LTGBLSN/Studying-Wheel-Legged-Robots-Damiao-/wheel-legged-master/打印件版/硬件接线图/实物图.jpg

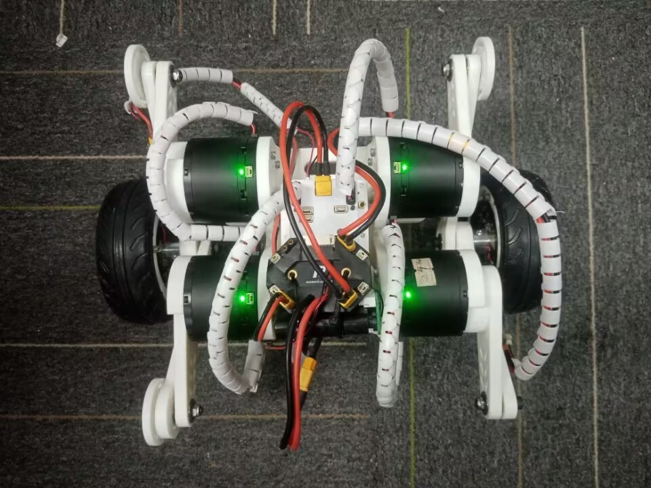
wheel-legged-master/打印件版/硬件接线图/实物图.jpg
