LTGBLSN/Studying-Wheel-Legged-Robots-Damiao-/wheel-legged-master/打印件版/代码/DM-balance打印件版本/电机零点图.jpg

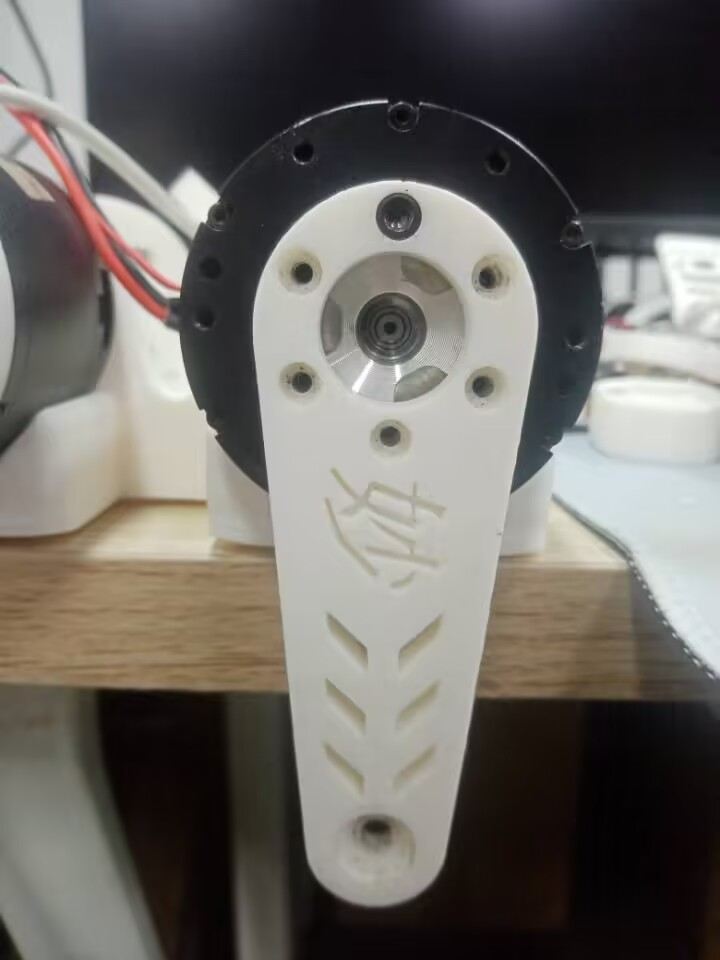
wheel-legged-master/打印件版/代码/DM-balance打印件版本/电机零点图.jpg
