LTGBLSN/Studying-Wheel-Legged-Robots-Damiao-/wheel-legged-master/打印件版/硬件接线图/轮足硬件接线图.png

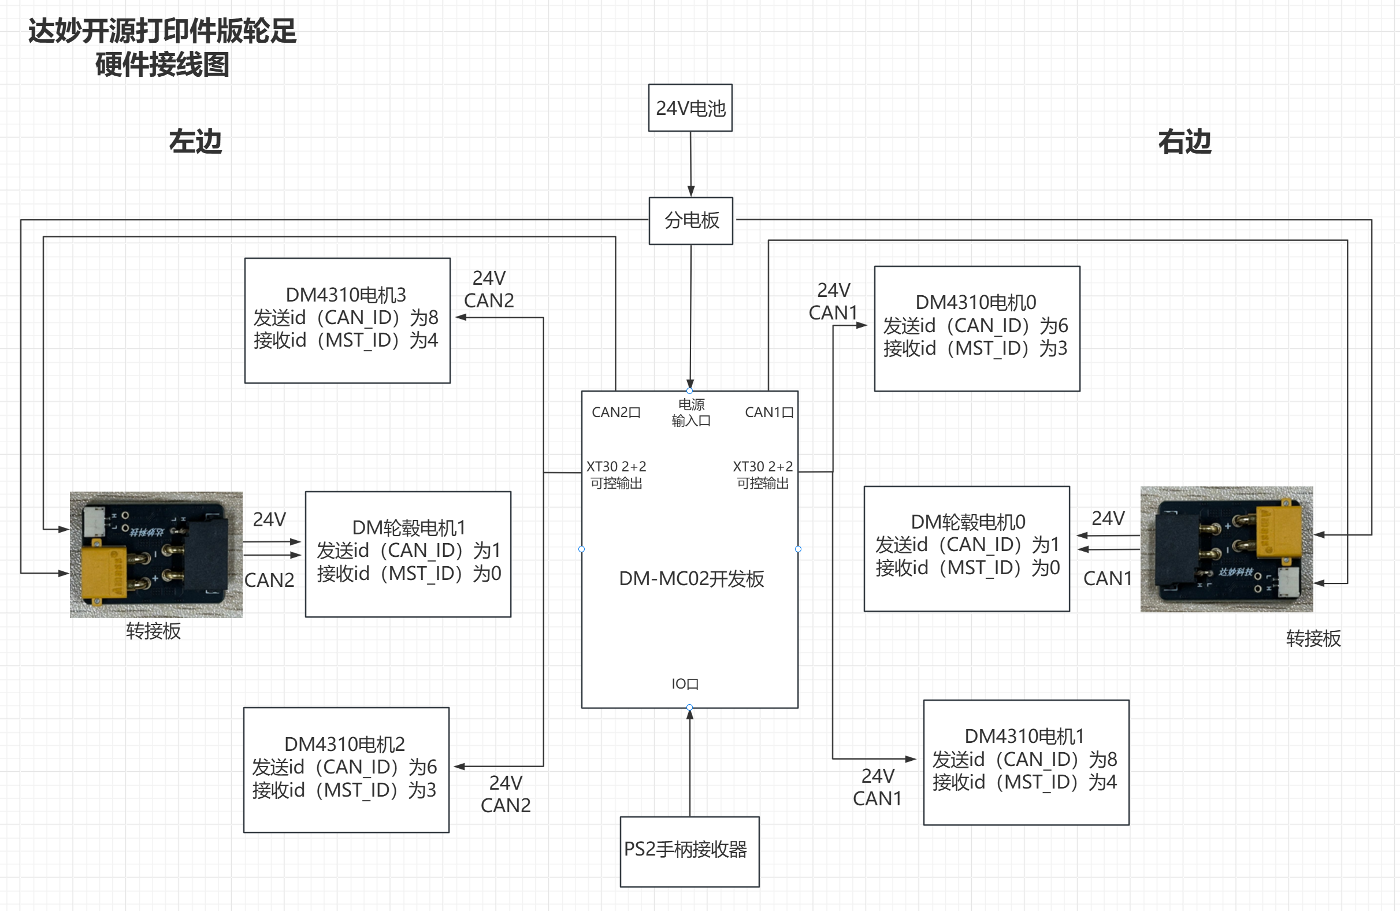
wheel-legged-master/打印件版/硬件接线图/轮足硬件接线图.png
