LTGBLSN/Studying-Wheel-Legged-Robots-Damiao-/轮腿开源（相关物料）/主控板-上壳 - 原装上壳太薄了打印出来变形,并增加了引脚的开窗.SLDPRT

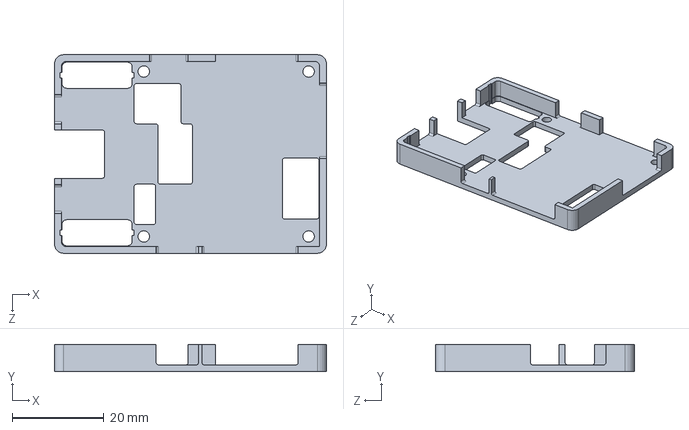
[picture p40: CAD file, 2025-12-11]
轮腿开源（相关物料）/主控板-上壳 - 原装上壳太薄了打印出来变形,并增加了引脚的开窗.SLDPRT
59.4 x 6.00 x 43.4 mm
