LTGBLSN/Studying-Wheel-Legged-Robots-Damiao-/轮腿开源（相关物料）/轮毂打印件-内圈.STL

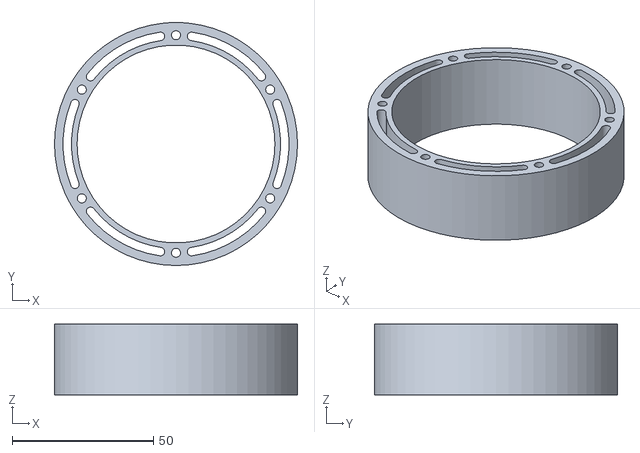
[picture p41: CAD file, 2025-12-11]
轮腿开源（相关物料）/轮毂打印件-内圈.STL
86.0 x 86.0 x 25.0
