LTGBLSN/Studying-Wheel-Legged-Robots-Damiao-/轮腿开源（相关物料）/轮毂打印件-下盖片.STL

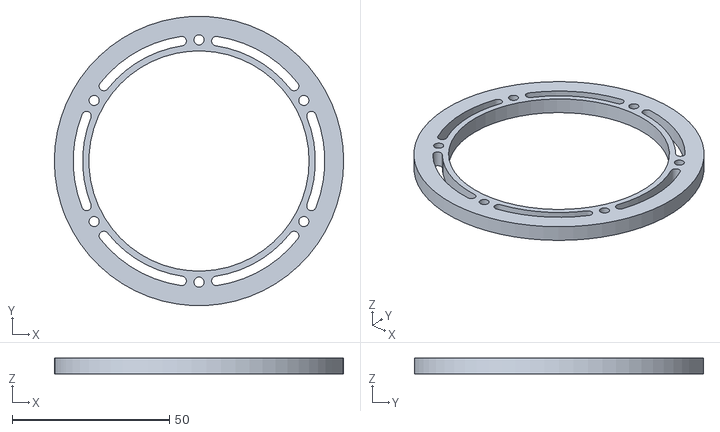
[picture p42: CAD file, 2025-12-11]
轮腿开源（相关物料）/轮毂打印件-下盖片.STL
92.0 x 91.9 x 5.00
