LTGBLSN/Studying-Wheel-Legged-Robots-Damiao-/wheel-legged-master/打印件版/结构件/6215_轮毂电机3d模型20230511.sldprt

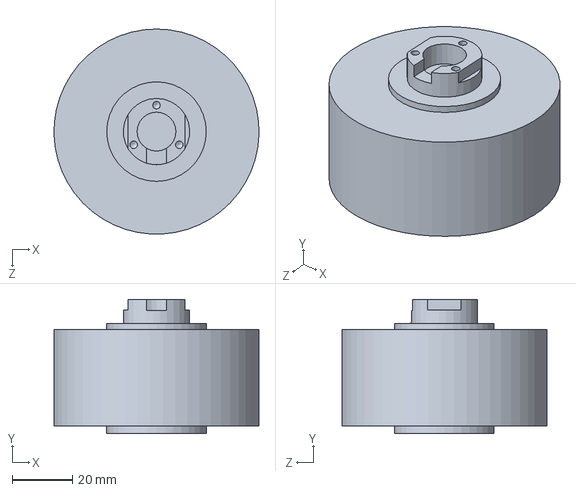
[picture p43: CAD file, 2025-12-11]
wheel-legged-master/打印件版/结构件/6215_轮毂电机3d模型20230511.sldprt
68.0 x 44.5 x 67.9 mm
