LTGBLSN/Studying-Wheel-Legged-Robots-Damiao-/轮腿开源（相关物料）/电池底板-横放电池.SLDPRT

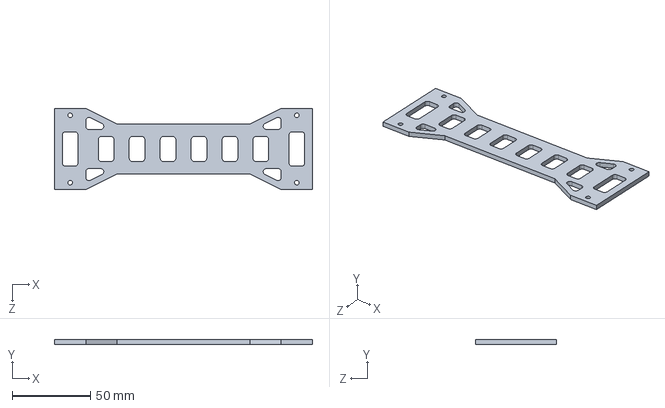
[picture p44: CAD file, 2025-12-11]
轮腿开源（相关物料）/电池底板-横放电池.SLDPRT
165.0 x 3.00 x 52.0 mm
