LTGBLSN/Studying-Wheel-Legged-Robots-Damiao-/(list of files, cad)

Other CAD files:
wheel-legged-master/打印件版/结构件/00-底盘.sldasm
wheel-legged-master/打印件版/结构件/电池盒.sldasm
wheel-legged-master/打印件版/结构件/0-双腿平衡机器人.sldasm
wheel-legged-master/打印件版/结构件/电池盒盒上板.sldasm
wheel-legged-master/打印件版/结构件/轮腿组1.sldasm
wheel-legged-master/打印件版/结构件/电池盒下板-233573.sldasm
wheel-legged-master/打印件版/结构件/电机-轮.sldasm
wheel-legged-master/打印件版/结构件/dm_4340_电机_3d20240116.sldasm
wheel-legged-master/打印件版/结构件/轮足.sldasm
wheel-legged-master/打印件版/结构件/轮腿组2.sldasm
wheel-legged-master/打印件版/结构件/壳体.sldasm
wheel-legged-master/打印件版/结构件/下壳.sldprt
轮腿开源（相关物料）/轮毂打印件-内圈69mm3_1mm安装孔.stp
wheel-legged-master/打印件版/结构件/轮毂打印垫片.sldprt
wheel-legged-master/打印件版/结构件/gb_t_70_1_-_2008_m5螺丝-20.sldprt
wheel-legged-master/打印件版/结构件/5x2实心轮胎.sldprt
wheel-legged-master/打印件版/结构件/垫片-m5-8-0_5.sldprt
wheel-legged-master/打印件版/结构件/gb_t_6172_2_-_2016_m5螺母.sldprt
wheel-legged-master/打印件版/结构件/连杆4.sldprt
wheel-legged-master/打印件版/结构件/gb_t_70_1_-_2008_m3螺丝-35.sldprt
wheel-legged-master/打印件版/结构件/轮毂打印件-内圈.sldprt
wheel-legged-master/打印件版/结构件/电池盒下板-692271.sldprt
wheel-legged-master/打印件版/结构件/gb_t_6172_2_-_2016_m2_5螺母.sldprt
wheel-legged-master/打印件版/结构件/ctrboard-h7_v1_0-240112_1_1.sldprt
wheel-legged-master/打印件版/结构件/gb_t_70_1_-_2008_m5螺丝-30.sldprt
wheel-legged-master/打印件版/结构件/robomaster中心板-step.sldprt
wheel-legged-master/打印件版/结构件/电机连接打印件.sldprt
wheel-legged-master/打印件版/结构件/底盘.sldprt
wheel-legged-master/打印件版/结构件/电池盒上板.sldprt
wheel-legged-master/打印件版/结构件/dm_4340_电机_3d20240116_1.sldprt
wheel-legged-master/打印件版/结构件/轮毂打印件-下盖片.sldprt
wheel-legged-master/打印件版/结构件/挡块-2.sldprt
wheel-legged-master/打印件版/结构件/5-13-4法兰轴承.sldprt
wheel-legged-master/打印件版/结构件/电池6s.sldprt
wheel-legged-master/打印件版/结构件/支撑轮.sldprt
wheel-legged-master/打印件版/结构件/gb_t_70_1_-_2008_m3螺丝-25.sldprt
wheel-legged-master/打印件版/结构件/gb_t_70_1_-_2008_m3螺丝-40.sldprt
wheel-legged-master/打印件版/结构件/上壳-1.sldprt
wheel-legged-master/打印件版/结构件/gb_t_70_1_-_2008_m3螺丝-12.sldprt
wheel-legged-master/打印件版/结构件/连杆3.sldprt
wheel-legged-master/打印件版/结构件/gb_t_70_1_-_2008_m3螺丝-15.sldprt
wheel-legged-master/打印件版/结构件/gb_t_6172_2_-_2016_m3螺母.sldprt
wheel-legged-master/打印件版/结构件/轮毂打印件-上盖片.sldprt
wheel-legged-master/打印件版/结构件/gb_t_70_1_-_2008_m2_5螺丝-20.sldprt
wheel-legged-master/打印件版/结构件/挡块-1.sldprt
wheel-legged-master/打印件版/结构件/尼龙柱-3_2-5-25mm.sldprt
wheel-legged-master/打印件版/结构件/连杆2.sldprt
wheel-legged-master/打印件版/结构件/gb_t_70_1_-_2008_m3螺丝-10.sldprt
wheel-legged-master/打印件版/结构件/连杆1.sldprt
轮腿开源（相关物料）/轮毂打印件-内圈69mm3_1mm安装孔.sldprt
轮腿开源（相关物料）/轮毂打印件-内圈69mm3_1mm安装孔.stl
