LTGBLSN/Studying-Wheel-Legged-Robots-Damiao-/(list of files, drawings)

Other design files:
轮腿开源（相关物料）/达妙分电板_36mm间距_单板_V1.3.epro
