LTGBLSN/Studying-Wheel-Legged-Robots-Damiao-/(notices)

Notices in the files:
wheel-legged-master/打印件版/代码/DM-balance打印件版本/DM-balanceV1/Core/Src/main.c:
Copyright (c) 2024 STMicroelectronics.
All rights reserved.
This software is licensed under terms that can be found in the LICENSE file
